rodarima/robotica/doc/coco.pdf

# Coco

Rodrigo Arias Mallo
rodrigo.arias@udc.es

## 1. Descripción

Coco es un robot diseñado para aprender los principios básicos de la robótica. Ha sido creado con la intención de reutilizar componentes de antiguos aparatos y darles un nuevo uso. Así como para comprender los fundamentos teóricos aplicados en un experimento práctico.

### 1.1. Sensores

Cuenta con varios sensores que le permiten obtener información del entorno, así como información sobre sí mismo. A cada sensor se le asigna un nombre corto, terminado en un número, que permite identificarlo. Los sensores son los siguientes:

1. sonar0: Sensor de ultrasonidos HC-SR04
2. mouse0: Ratón de bola
3. ldr0: Sensor de luz LDR ambiental
4. ldr1: Sensor de luz LDR dirigido hacia delante
5. antr: Antena derecha
6. antl: Antena izquierda

### 1.2. Actuadores

El robot dispone de dos motores DC a ambos lados que le permiten moverse por el entorno. También puede emitir señales a través de sus leds. Incluye tres LEDS en la parte frontal, que conjuntamente con el sensor ldr1, le permiten apreciar el color del objeto que tiene delante. A continuación:

1. mtr: Motor derecho
2. mtl: Motor izquierdo
3. ledr: LED frontal rojo.
4. ledg: LED frontal verde.
5. ledb: LED frontal azul.
6. led0: LED de información.

## 2. Calibración de sensores

### 2.1. sonar0: Ultrasonidos HC-SR04

El sensor de ultrasonidos, permite averiguar de forma estimada la posición de un obstáculo. Para ello dispone de un emisor y un receptor de ultrasonidos orientados hacia delante, y posicionados en la parte frontal del robot.

Para calcular la distancia al objeto, se mide el tiempo que tarda un pulso ultrasónico en viajar desde el emisor al objeto, y tras rebotar, volver al receptor.

Ya que el sonido ha de rebotar en el objeto, la superficie del mismo influirá en gran medida en la información captada por el sensor. Las superfies de tela o espuma, absorben casi todo el sonido que emite el sensor, por lo que son indetectables para el robot.

La velocidad del sonido, depende de la temperatura del aire T, además de otros factores¹
. Sin embargo,
para una simplificación de los cálculos, se empleará la siguiente fórmula, asumiendo que la temperatura T en grados Celsius es la misma en todas partes:
vs = 331,3 + 0,606T | (1)

Por lo tanto, si te es el tiempo que tarda el sonido en llegar desde el emisor al obstáculo, y tr el tiempo desde que rebota en el obstáculo hasta el receptor:

s1 = vste s2 = vstr

s1 es la distancia del sensor al objeto, en el momento de lanzar el pulso. s2 es la distancia desde el objeto al robot, que puede estar en movimiento y ser diferente a s1. El sensor mide t que es te + tr.

Si se supone que el robot esta parado cuando se realiza la medición, s1 = s2 y por tanto te = tr. Finalmente, s es la distancia del sensor al obstáculo:

s = s1 = s2 = vs

t
2

(2)

Es importante mencionar que s no indica la posición exacta del obstáculo, si no la distancia del mismo al sensor.

En el caso de que el robot se mueva con una velocidad ~v, si esta velocidad es pequeña comparada con la del sonido, se puede despreciar. Una velocidad de 1m/s, provocaría una diferencia en la distancia estimada de un objeto a 3m, de aproximadamente 9mm.

### 2.1.1. Ángulo de apertura θs

Para calibrar el sensor, es necesario determinar el ángulo de apertura θs, que indica hasta que punto el sensor puede recibir el eco del sonido que rebota en los objetos. De modo que se realizarán una serie de experimentos, que indicarán de forma experimental dicho ángulo. En la figura 1 se observa un esquema del experimento.

Primero un objeto se coloca en el campo de visión del sensor, en C1. Luego se desplaza hacia A2, siguiendo una trayectoria circular centrada en O, y se observa el ángulo θ1 en el que deja de observarse dicho objeto. De igual modo se repite en el otro sentido, y se calcula el ángulo θ2.

Dado que el sonar puede no estar centrado, se anotarán las medidas de θ1 y θ2, para luego estimar θs.

Tras realizar las mediciones, se obtienen los siguientes resultados:

1http://en.wikipedia.org/wiki/Speed_of_sound#

Practical_formula_for_dry_air (http://en.wikipedia.org/wiki/Speed_of_sound#Practical_formula_for_dry_air)

C2

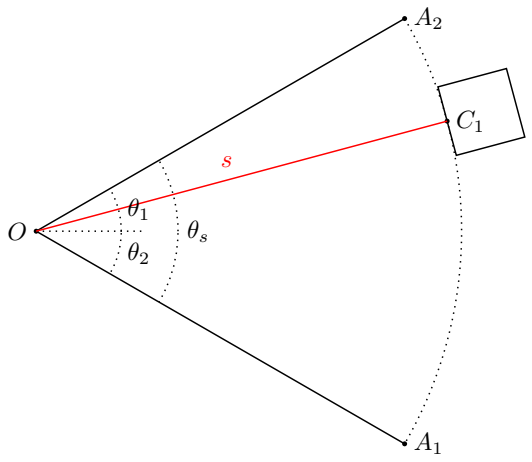
[picture p11: figure]

Figura 1: Experimento para calcular el ángulo θs en el sensor de ultrasonido.

s (m) | θ1( o ) | θ2( o )
±5mm | ±1 o | ±1 o
0,20 | 30 | 27
0,30 | 30 | 27
0,40 | 31 | 28
0,50 | 28 | 26
0,60 | 30 | 28
0,80 | 31 | 29
1,00 | 29 | 29
1,20 | 30 | 28

De forma que se aproxima el valor empleando la media aritmética a:

θ1 = 30 ± 1

o
θ2 = 28 ± 1

o

Finalmente, para θs:

θs = 58 ± 2

o

El fabricante indica un ángulo de apertura de 60o ,
centrado, con 30o hacia cada lado. De forma que el resultado obtenido experimentalmente se acerca bastante al resultado esperado.

### 2.1.2. Distancia medida

Para completar la calibración, es necesario poder calcular la distancia s, sabiendo el tiempo t. Para ello, se realizará otro experimento, midiendo las distancias de forma manual sr con una regla, y comparándolas con el valor teórico st, calculado con la ecuación 2.

Se observa que el valor teórico st, no coincide con el valor real medido sr.

sr(m) | st(m) | t(µs)
±0, 05 | | ±20
0,20 | 0,138 | 805
0,30 | 0,210 | 1225
0,40 | 0,281 | 1638
0,50 | 0,353 | 2060
0,60 | 0,429 | 2500
0,80 | 0,568 | 3305
1,00 | 0,713 | 4155
1,20 | 0,859 | 5000
0,2 | 0,4 | 0,6 | 0,8 | 1 | 1,2

1,000

2,000

3,000

4,000

5,000

6,000

7,000

## Distancia del objeto (m)

## Tiempo de eco (

µs)

Erróneo | Corregido | T eórico

Figura 2: Valores experimentales del sensor de ultrasonidos.

Sería posible solucionar el problema empleando una corrección del error. Para ello se emplea una regresión lineal. Con Octave, polyfit muestra los coeficientes de la recta:

2.3864e+02 7.8846e-03

Cuya recta (azul) se puede observar en la figura 2. Su ecuación es:

s = 238,64t + 7,8846 · 10⁻³

Después de repasar el programa que muestra el tiempo que tarda el pulso de ultrasonidos en regresar, se ha detectado un error, provocado en una función de las bibliotecas de Arduino.

Resulta que la función pulseIn calcula el tiempo que dura un pulso, empleando un bucle, en el que se incrementa un contador. Luego multiplica las vueltas del bucle por el número de instrucciones que de antemano se han calculado. Sin embargo, el compilador avr-gcc puede alterar el número de instrucciones cuando se aplican optimizaciones. Este problema, provoca que el tiempo se vea alterado de la forma treal = t ∗ K. Siendo K = 1,3898, hallado de forma experimental.

Tras programar una nueva biblioteca para emplear el sensor de ultrasonidos, de forma independiente a las optimizaciones del código (empleando interrupciones), se vuelven a realizar las medidas.

sr | st | t
m | m | µs
0.20 | 0.193 | 1122
0.30 | 0.293 | 1705
0.40 | 0.392 | 2285
0.50 | 0.489 | 2848
0.60 | 0.588 | 3422
0.80 | 0.789 | 4597
1.00 | 0.998 | 5810
1.20 | 1.197 | 6970

Obteniendo por regresión lineal, de la misma forma, los coeficientes:

1.7084e+02 1.0857e-02

Y por tanto, la recta característica (negro) es:

s = 170,84t + 1,0857 · 10⁻² = 341,68

t
2

+ 1,0857 · 10⁻²

Existe un error fijo de aproximadamente un centímetro (1.0857cm), que puede deberse a la dificultad de centrar la regla en el centro del sensor de ultrasonidos. Sin embargo, para determinar la distancia de un objeto al robot, esta distancia es despreciable.

Si comparamos la ecuación 1, con el resultado experimental, despreciando el desplazamiento de 1cm, se puede observar que son muy similares.

En la figura 2 la recta teórica en rojo, es muy similar a la recta experimental corregida, en negro.

La velocidad del sonido calculada de forma experimental, resulta ser 341,68 m/s. Este valor puede oscilar, ya que depende de la temperatura. Para calcular la temperatura:

T =

vs − 331,3
0,606

= 17,129◦C

La temperatura registrada de la sala es de 18o
. Por lo
que se puede afirmar que el experimento muestra unos resultados esperados.

El error medio de distancia cometido, en el peor caso (a 1.20m de distancia real) es de unos 4mm.

Es importante mencionar, que un ajuste del error, empleando un método de regresión, permite solventar errores como el que ha sido detectado, pero no los corrige. Por ello, se ha decidido que si los cálculos teóricos, no concuerdan con los esperados, debe averiguarse que ha causado el error.

### 2.2. LDR

El sensor LDR permite obtener una medida de la cantidad de luz que incide sobre el mismo. El robot dispone de dos sensores LDR. Uno ambiental, que está colocado en la parte superior, orientado hacia arriba. Además está cubierto por un cilindro cerrado de 4cm de altura, de plástico blanco translúcido. Esto le permite obtener una medida de la luz ambiente sin importar la dirección de donde proviene.

El sensor LDR direccional, se encuentra en la parte delantera orientado al frente. Este sin embargo, está encapsulado en un cilindro abierto, de plástico negro opaco. Lo cual le permite observar de forma direccional la luz que recibe por el frente, con el objetivo de encontrar una luz.

### 2.2.1. ldr0: LDR ambiental

Para calibrar el sensor ambiental, se realizarán algunas medidas comparando la distancia a un foco de luz. También se compararán los valores con distintos ángulos, para observar si realmente es invariante a la orientación.

El valor medido por el sensor, está representado en un intervalo [0, 1024) de valores discretos. El valor 0, corresponde con un voltaje de 0V en la entrada de Arduino, y 1023 con +5V. De forma que si l0 es el valor discreto medido por Arduino:

V0 = 5 ·

l0
1023

En la figura 3 se observa el montaje del LDR R2, junto con otra resistencia R1 de un valor fijo de 10kΩ.

R1

V0

R2

V

Figura 3: Circuito del sensor LDR.

Para calibrar el sensor ambiental, se realizarán algunas medidas observando el valor de la resistencia del LDR, mientras se varía la distancia del foco de luz, así como el ángulo.

En cada medida, el sensor realiza 5000 mediciones de forma contínua, y luego envía el valor de la media aritmética al ordenador, que es registrado.

s(m) | 0 o | −90o | +90o | +180o
0.20 | 936 | 926 | 933 | 943
0.40 | 823 | 784 | 831 | 843
0.60 | 719 | 675 | 729 | 742
0.80 | 627 | 576 | 628 | 639
1.00 | 555 | 505 | 560 | 531
1.20 | 500 | 445 | 497 | 489
1.40 | 429 | 396 | 446 | 454
1.60 | 396 | 340 | 407 | 440
1.80 | 378 | 296 | 383 | 405

Cuadro 1: Datos de calibración para ldr0.

0,2 0,4 0,6 0,8 | 1 | 1,2 1,4 1,6 1,8

10²,4

10²,5

10²,6

10²,7

10²,8

10²,9

10³

Distancia a la luz (m)

Valor del sensor

0

o | −90o | 90o | 180o

Figura 4: Resultados de calibración para ldr0.

En la tabla 1, s indica la distancia a la fuente de luz. Los ángulos indican la orientación del robot.

En la figura 4, se puede observar en una escala logarítmica para el eje y, el valor del sensor para cada orientación.

Existe una variación bastante marcada en la orientación de −90o
. Esta variación indica que el sensor recibe menos luz de la esperada. Dicha variación está relacionada con la superficie del robot. Dado que hay cables en la superficie, cuando se coloca a −90o
, los
cables se sitúan entre la luz y el sensor, y provocan una disminución de la intensidad.

En las demás orientaciones no se producen grandes cambios. Por lo que se asume que el sensor es realmente independiente de la orientación.

### 2.2.2. ldr1: LDR direccional

El sensor LDR direccional, por el contrario, trata de aumentar la variación de la luz conforme a la orientación. Para calibrar este sensor se realizará un experimento similar, dividido en 4 orientaciones. Se asume que los valores para los ángulos opuestos, dada la simetría, son iguales.

Se muestran en la tabla 2 los resultados obtenidos. Finalmente, en la figura 5, se muestran también en una escala logarítmica para el valor del sensor.

s(m) | o 0 | 30o | 60o | 90o
0.10 | 1015 | 1011 | 1004 | 977
0.20 | 1015 | 998 | 670 | 404
0.30 | 1013 | 915 | 520 | 414
0.40 | 1011 | 838 | 416 | 314
0.50 | 1008 | 684 | 308 | 254
0.60 | 1004 | 534 | 216 | 202
0.70 | 999 | 500 | 214 | 113
0.80 | 996 | 394 | 188 | 95
0.90 | 992 | 355 | 164 | 80
1.00 | 987 | 352 | 136 | 70
1.20 | 977 | 277 | 96 | 60
1.40 | 968 | 173 | 65 | 57

Cuadro 2: Datos de calibración de ldr1.

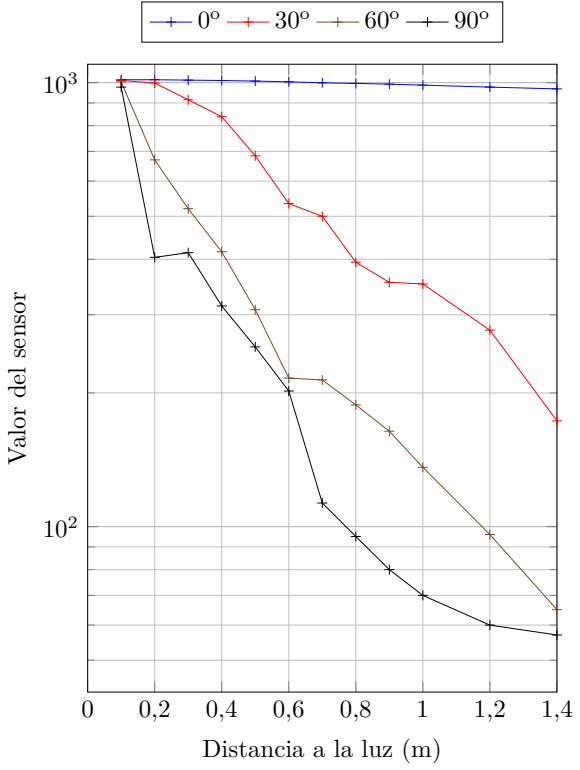
[picture p12: figure]
Distancia a la luz (m); Valor del sensor

Figura 5: Resultados de calibración para ldr1.

### 2.3. mouse0: Ratón de bola

En la parte posterior, un ratón de bola permite obtener mediciones del movimiento del robot. Tiene un controlador EM83702BP, que dispone con dos contadores digitales que realizan la medición del desplazamiento en el eje x e y.

Una bola de goma se encuentra en contacto con el suelo. Al desplazar el ratón, la bola gira alrededor de un eje imaginario, que es perpendicular al sentido del desplazamiento y paralelo al suelo. Desplazándose en la dirección de ~m.

Ya que los movimientos efectuados por el robot serán los que provoquen sus dos ruedas, se puede determinar la posición, midiendo sólo el desplazamiento del ratón. Para ello, se observa en la figura 7 un ejemplo de un giro de α = 45o

### 2.3.1. Movimiento de la bola

Para poder analizar el movimiento que realizará el robot, mediante la información que el ratón proporciona, es necesario conocer como varía el vector ~m que indica el desplazamiento real del ratón, con respecto a la información proporcionada por el mismo.

Para ello, es necesario averiguar el funcionamiento del ratón. Este consta de una bola de goma, que está situada en un zócalo, donde puede girar libremente, al mover el ratón por una superficie.

Dos rodillos de plástico rozan con la bola, desfasados en un ángulo de 90o
. A continuación se analiza, como el movimiento de la bola, roza en los puntos B1 y B2 con los rodillos del ratón. En la figura 15 se observa con detalle el mismo giro que en la figura 7.

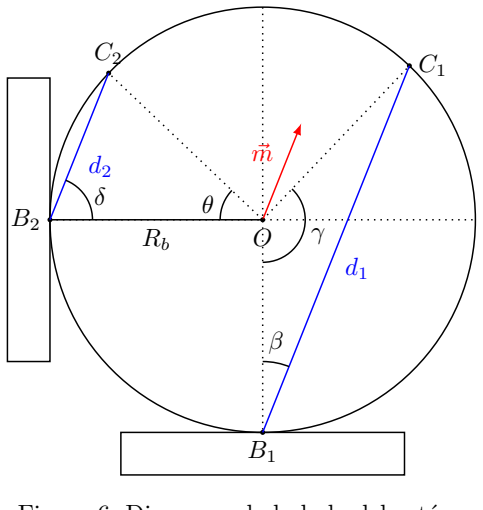
[picture p13: figure]

Figura 6: Diagrama de la bola del ratón.

### 2.3.2. El tamaño de la bola

¿Cómo se mueven los rodillos del ratón, cuando la bola gira? Para responder a esta cuestión, se moverá el ratón un desplazamiento ~m a una velocidad uniforme y en línea recta, y se intentará calcular de forma teórica el resultado esperado.

Los ejes están intercambiados con respecto al orden habitual de un plano. Esto es debido a que el ratón está colocado en el robot como en la figura 15. Sin embargo mantienen el sentido. Hacia arriba y derecha son positivos.

El rodillo inferior, girará rozando continuamente por el punto B1 a medida que la bola gire. Dado que la dirección ~m permanece constante durante este movimiento, el punto B1 describirá una trayectoria circular en la superficie de la bola. La bola tiene un radio Rb.

El perímetro de esta circunferencia se denomina por p1, que es tangente a B1 y C1 y que tiene por diámetro d1. De modo que cuando la bola dé una vuelta completa, el rodillo habrá avanzado exactamente p1.

La distancia d1 es la cuerda de ángulo γ, cuya longitud es, por su propia definición:

d1 = Rb crd γ = 2Rb sin

γ
2

Además, el ángulo γ = 180o−2β, pues forma un triángulo isósceles:

d1 = 2Rb sin(90 − β) = 2Rb cos β

De igual modo para d2:

d2 = Rb crd θ = 2Rb sin

θ
2

Sabiendo que θ = 180o − 2δ y que β = 90 − δ, puesto que d1 k d2:

d2 = 2Rb sin(90 − δ) = 2Rb sin β

Finalmente, para los perímetros:

p1 =

2πd1
2

= 2πRb cos β p2 =

2πd2
2

= 2πRb sin β

Si se supone que no hay ningún deslizamiento entre la bola y el rodillo, cuando la bola avance ~m, ésta girará un ángulo θb:
θb =

m
Rb

Si Rr es el radio de los rodillos, estos girarán un ángulo:

θ1 =

θbd1
2Rr

θ2 =

θbd2
2Rr
Sustituyendo d1 y d2:

θ1 =

θb2Rb cos β
2Rr

=

Rb
Rr

θb cos β

θ2 =

θb2Rb sin β
2Rr

=

Rb
Rr

θb sin β

Recuperando el valor de θb, el radio Rb desaparece:

θ1 =

m cos β
Rr

θ2 =

m sin β
Rr

(3)

De modo que se obtiene una relación entre el ángulo con el que se desplaza el ratón y el giro de cada uno de los rodillos, como se deseaba. Además se observa que el tamaño no importa, de la bola, para calcular el giro de los rodillos.

### 2.3.3. Los optoreceptores

Los rodillos que rozan con la bola, tienen en los extremos unos discos con ranuras equiespaciadas, de modo que cortan un haz de luz infrarrojo al girar. Este efecto, provoca que un sensor registre el número de veces que se ha cortado el haz, y por lo tanto mide, de forma discreta, cuánto ha girado el rodillo, es decir θ1 y θ2.

Cada disco tiene 27 dientes y Rr, el radio de los rodillos, es de 1.4±0.1 mm.

Además, en cada disco se encuentran dos receptores, desfasados 90o
, de forma que pueden detectar el sentido de giro. Por cada diente que se avanza, se cuentan 4 pasos en los contadores digitales.

Si o1 y o2 son los valores medidos por los contadores que acumulan el número de pasos que se ha desplazado el rodillo:

o1 =

27 · 4θ1
2π

o2 =

27 · 4θ2
2π

Sustituyendo el valor del ángulo θ1 y θ2 por la ecuación 3:

o1 =

27 · 4
2πRr

m cos β o2 =

27 · 4
2πRr

m sin β

Añadiendo una constante Kr:

Kr =

27 · 4
2πRr

= 12 ± 2

o1 = Krm cos β o2 = Krm sin β

Esta constante, Kr, ha sido calculada de forma experimental, con un valor de 11,484. Este valor se encuentra dentro del margen calculado, por lo que se considera como válido, y verifica los cálculos realizados.

Kr = 11, 484

Para calcular esta constante, se realizó un movimiento de 150mm, en línea recta y se registraron los valores de o1, que mide el desplazamiento en el eje y:

o1 | 1719 | 1728 | 1722 | 1719 | 1725

Tras calcular la media, y dividirla por 150mm, se obtiene el valor Kr.

Empleando una notación vectorial, ~o es el desplazamiento indicado por el ratón, tras intercambiar sus ejes: ~o = (o2, o1).

De forma que ox = o2 = Krm sin β y oy = o1 = Krm cos β. Ya que mx = m sin β y my = m cos β, se simplifica: ox = Krmx y oy = Krmy, quedando finalmente:

~o = Kr ~m =⇒ ~m =

~o
Kr

(4)

### 2.3.4. El radio de giro Rr

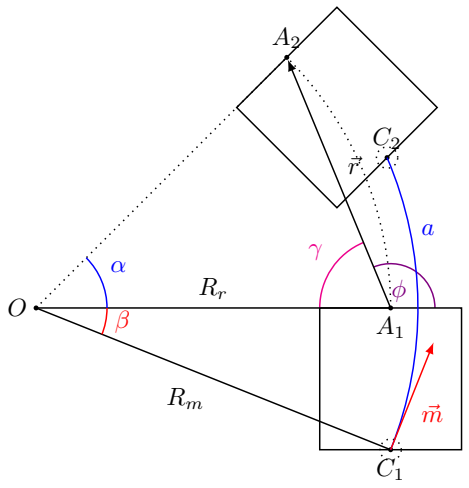
[picture p14: figure]

Figura 7: Diagrama de un giro del robot.

Para calcular el radio de giro Rr del robot se empleará el triángulo OA1C1 que comparte el lado Rr con el triángulo OA2A1.

l es la distancia que separa el ratón del eje de las ruedas, l = A1C1. Rm es el radio desde el O hasta el ratón, C1.

Observando el ángulo β se cumple que:

sin β =

l
Rm

=

mx
m

=⇒ Rm =

l · m
mx

(5)

Ahora, tomando el triángulo OA1C1:

Rr = Rmcosβ = Rm

my
m

=

l · m · my
mx · m

=

l · my
mx

(6)

### 2.3.5. El ángulo α

En un giro el robot mueve el ratón en la trayectoria descrita por el arco a, como muestra la figura 7. Dado que el ratón gira acompañando al robot, la trayectoria percibida por el mismo, es en línea recta, y de una longitud exactamente igual a a. De forma que:

m =

q
m²

x + m²
y = a

Si Rm = OC1, dado que α = A1dOA2 = C1dOC2, se tiene que a = αRm. Junto con lo anterior:

m = αRm

Empleando la ecuación 5:

α =

m
Rm

=

m · mx
l · m

=

mx
l

(7)

### 2.3.6. El vector ~r

Para determinar la posición del robot, es necesario calcular el vector ~r. Este vector indica el deplazamiento del robot, usando un sistema de coordenadas local. Observando el ángulo φ:

rx = r cos φ ry = r sin φ

En forma matricial, empleando Rφ como matriz de rotación:

~r =

rx
ry
= Rφ
r
0
=
cos φ − sin φ
sin φ cos φ

r
0
(8)

Y ya que r es la cuerda de radio Rr y ángulo α, se tiene que:

r = Rr crd α = 2Rr sin

| α
| 2

Junto con las ecuaciones 7 y 6:

r = 2Rr sin

mx
2l

=

2lmy mx | sin mx 2l

Dado que existe una división por mx que valdrá 0 cuando el robot avance en el eje y, es necesario evitar la división por cero:

r =

2lmy
mx

sin

mx
2l

si mx 6= 0

my | si mx = 0

(9)

### 2.3.7. El ángulo global θ

θ indica en un sistema de referencia global S, el ángulo del robot. En cada giro cambia, y ha de actualizarse. Si ∆θ es el giro que se produce en un intervalo ∆t, tras cada actualización:

θ(t + ∆t) = θ + ∆θ

Observando la figura 7, α indica el giro que describe el robot, en ∆t, por lo que ∆θ = α:

θ(t + ∆t) = θ + α | (10)

Siendo α el ángulo que gira el robot entre t y t + ∆t.

### 2.3.8. La posición global ~s

El vector ~s(t) indica la posición del robot en el instante t, tomando un sistema de referencia global S:

~s(t + ∆t) = ~s(t) + ∆~s

Sin embargo, el vector ~r(t), indicará el deplazamiento en el instante t, pero en el sistema de referencia del robot S

0

Para transformar el vector ~r de S

0 a S es necesario
tener en cuenta el ángulo θ que poseía el robot al comenzar el desplazamiento:

∆~s = Rθ~r

Substituyendo ~r por la ecuación 8:

∆~s = RθRφ

r
0
= Rθ+φ
r
0

Realizando la multiplicación de la matriz:

∆sx = r cos(θ + φ) ∆sy = r sin(θ + φ)

De forma que para cada ∆t:

sx(t + ∆t) = sx(t) + r cos(θ + φ) sy(t + ∆t) = sy(t) + r sin(θ + φ)

(11)

### 2.3.9. Odometría

Para determinar la ubicación del robot, bastará con conocer la posición y el ángulo del robot, usando el sistema de referencia global S. De esta forma, la tupla (~s, θ) contiene toda la información necesaria para ubicar al robot.

Cada vez que el sensor mouse0, indique el vector ~o, ha de calcularse ~m. Luego actualizar la posición global ~s y finalmente el ángulo global θ.

### 2.4. Motores

Para efectuar el movimiento, el robot dispone de dos motores Mabuchi RF-500TB-12560, colocados a ambos lados. Estos motores eléctricos de corriente contínua, son rápidos y ligeros, pero no tienen la precisión de los motores paso a paso. Así que para poder controlar la velocidad y aceleración, es necesario realizar una serie de pruebas de calibración.

### 2.4.1. Relación velocidad-voltaje

Aplicando diferentes configuraciones de ondas PWM, es posible variar la velocidad de los motores con arduino. De modo que se ha realizado un experimento en el que el robot ejecuta un movimiento en línea recta durante 2 segundos, manteniendo una alimentación constante en ambos motores. El resultado puede verse en la figura 8.

Se observa que al comienzo, los motores experimentan una aceleración, tras la cual, se estabilizan en una velocidad relativamente constante, y finalmente se detienen tras un período de frenado.

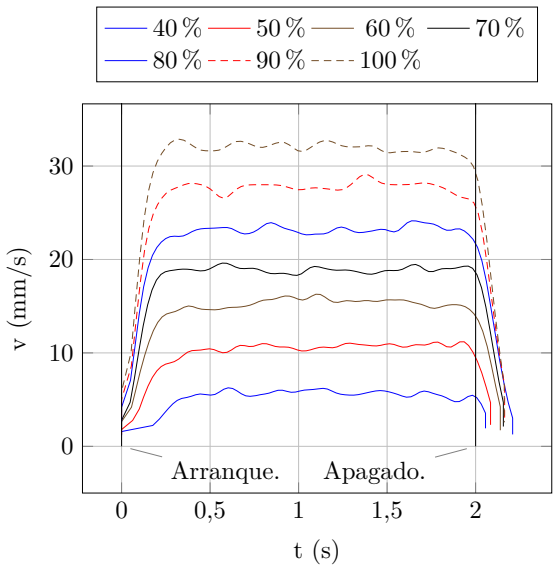
[picture p15: figure]
Arranque.; Apagado.

Figura 8: Arranque y parada de los motores, con diferente ciclo de trabajo, a 5V. Se observa una curva de arranque, y otra de detención, debido a la inercia.

Es importante conocer la velocidad de los motores, para poder tener una mejor información de odometría. En la figura 9 se observa como aumenta la velocidad conforme se aumenta el ciclo de trabajo de la onda PWM.

Las ecuaciones que describen la aceleración del motor permitirían contrastar la forma de la función. Sin embargo, no serán analizadas aquí, debido a la gran complejidad que conforma un motor. Para estimar la gráfica, se realizará una aproximación lineal. La interpolación que se muestra en la figura 9 es la siguiente recta:

f(x) = 41,9103x − 8,4458

## 3. Errores en las bibliotecas de

Arduino.

La función attachInterrupt no borra las banderas (flags) INTF0 y INTF1 del registro EIFR, de forma que al colocar una interrupción por primera vez, es posible que se ejecute al comienzo sin haber recibido tal interrupción. Una posible solución es añadir esta línea al comienzo de la función:

EIFR |= _BV(INTF0) || _BV(INTF1);

La función pulseIn calcula el tiempo transcurrido dependiendo del número de instrucciones que contiene un bucle. Este número puede variar con las optimizaciones que se realicen. Debe ser invariante.

Además es conveniente sustituirla por alguna función no bloqueante que emplee interrupciones.

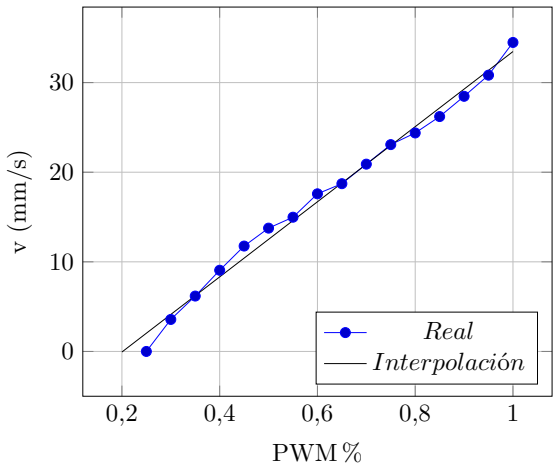
[picture p16: figure]
PWM %; Real Interpolación

Figura 9: Arranque y parada de los motores, con diferente ciclo de trabajo, a 5V. Se observa una curva de arranque, y otra de detención, debido a la inercia.

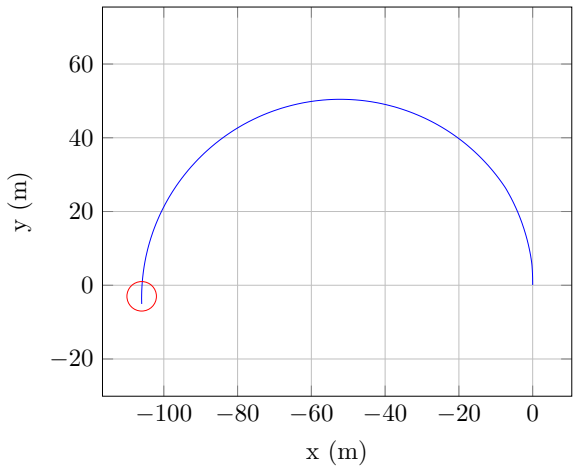
[picture p17: figure]

Figura 10: Giro de 180o
. Se observa que excede el giro en unos 5,5o
, debido a la inercia de los motores.

## 4. Trabajo futuro

Existen algunos temas que no se han podido tratar, por falta de tiempo. Son las ecuaciones que describen el comportamiento de la luz, cuando se varía la distancia a la fuente, o cuando se varía el ángulo del sensor.

Las ecuaciones del arranque del motor, se han ignorado, pero analizarlas podría mejorar los cálculos de odometría.

La última versión de este documento se encuentra en https://github.com/rodarima/robotica.

## 5. Detalles de los sensores

A continuación se muestran algunas fotos que muestran los sensores con detalle.

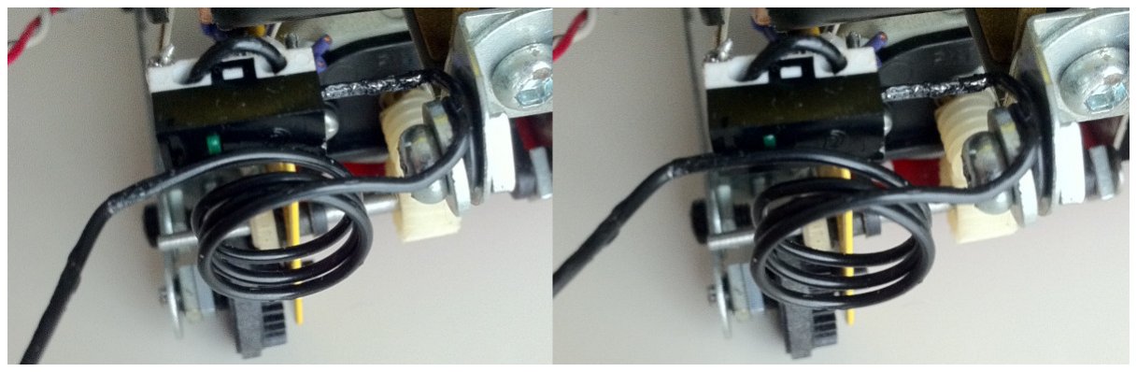
[picture p18: figure]

Figura 11: Detalle del mecanismo de las antenas: En la izquierda desactivada; en la derecha activada.


Figura 12: Sensor de luz ambiental ldr0.


Figura 13: Construcción del sensor ldr0.


Figura 14: Sensor direccional ldr1, junto a los leds RGB para identificar el color.


Figura 15: Se observa el interior del ratón de bola. Dos rodillos perpendiculares en contacto con la bola, con discos dentados en los extremos. Una marca blanca permite observar una desviación del robot.


Figura 16: Sensor de ultrasonidos snr0. El emisor se encuentra a la derecha (T) y el receptor a la izquierda (R).

## 6. Detalles del robot

Por último una visión general del robot.


Figura 17: Se observa el mecanismo de engranajes que transmiten la rotación del motor a las ruedas.


Figura 18: Batería de 1,2 · 8 = 9,6V. Gracias al grupo GII por las piezas.


Figura 19: Vista superior del robot.


Figura 20: Vista superior del robot desmontado.
