rodarima/robotica/doc/img/ant-closed.jpg

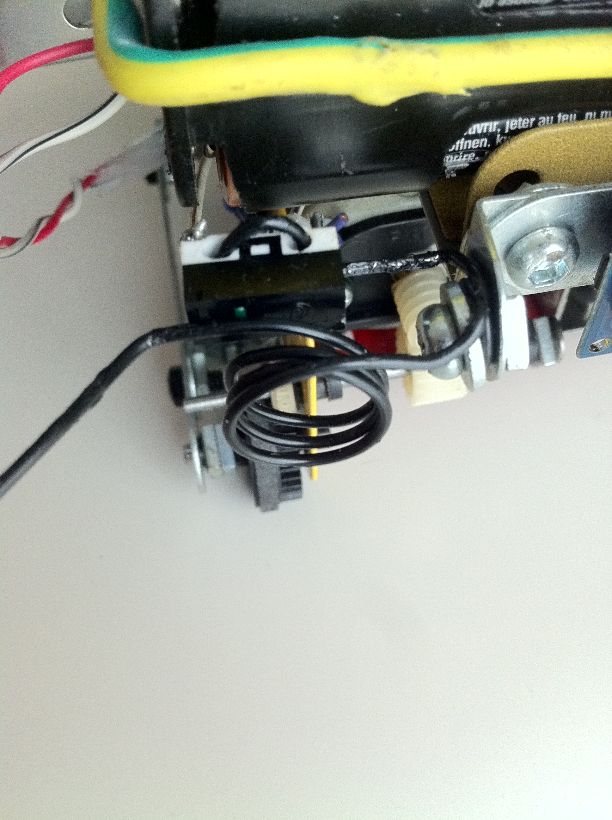
doc/img/ant-closed.jpg
