rodarima/robotica/doc/img/ant-open.jpg

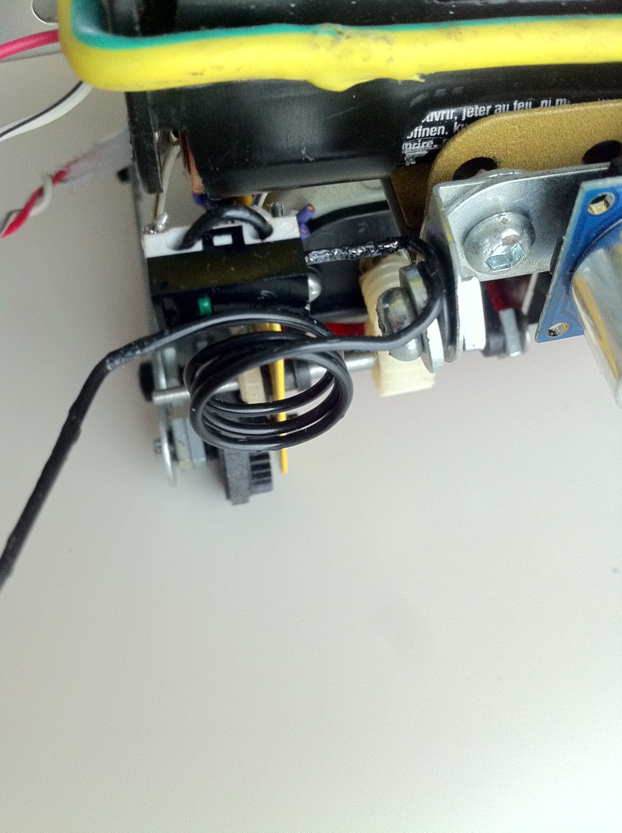
doc/img/ant-open.jpg
