rodarima/robotica/doc/img/coco-piezas.JPG

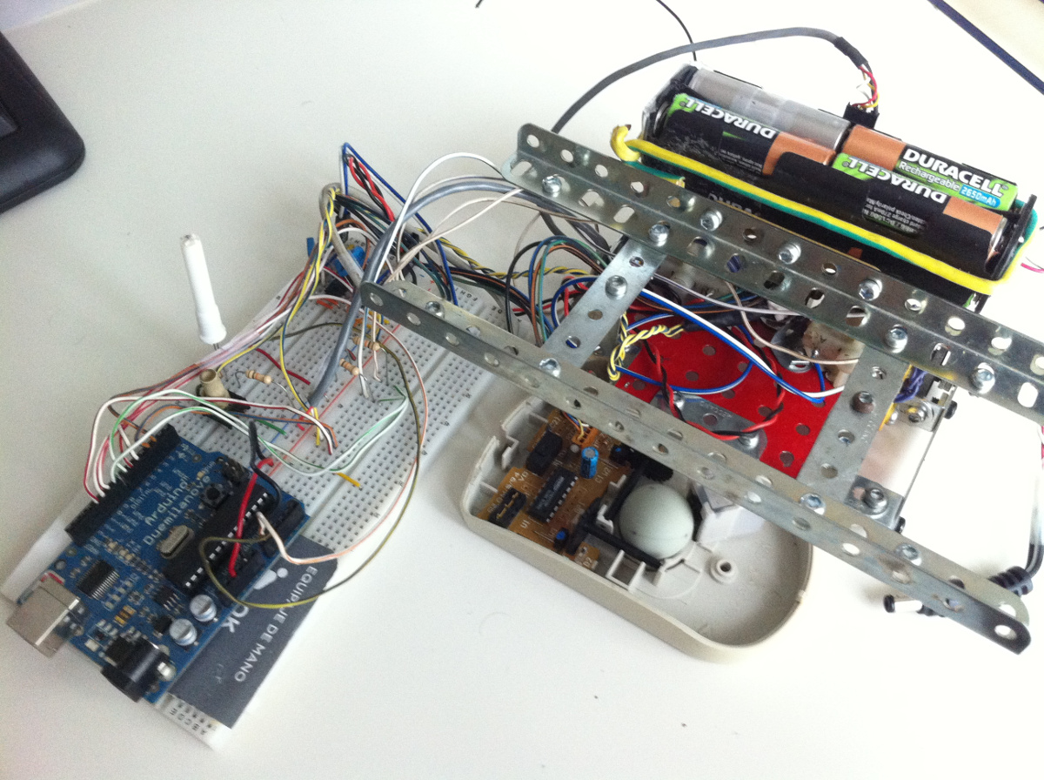
doc/img/coco-piezas.JPG
