rodarima/robotica/doc/giro1.dxf

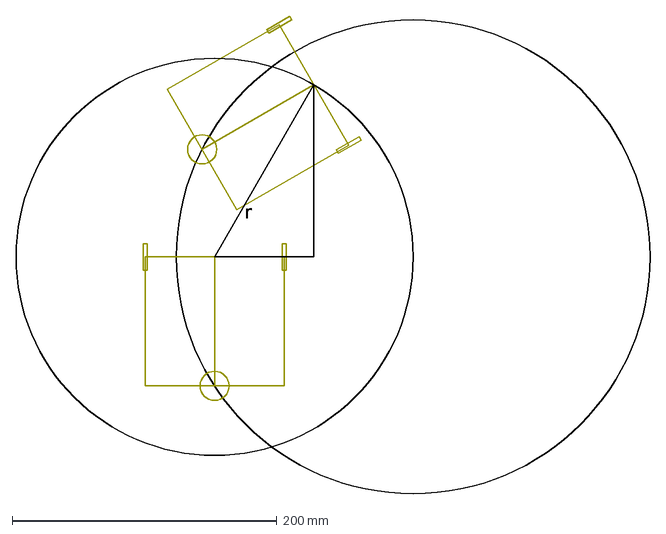
[picture p22: CAD file, 2015-03-03, last stored version]
doc/giro1.dxf
r
