rodarima/robotica/arduino/pinout.h

#ifndef _PINOUT_H_
#define _PINOUT_H_

/* Pines de los motores */
#define PIN_MTR0	9
#define PIN_MTR1	10
#define PIN_MTL0	5
#define PIN_MTL1	6

/* Pines del sensor de ultrasonidos */
#define PIN_SNR0S	11
#define PIN_SNR0R	3

/* Interrupción del eco */
#define INT_SNR0	1

#define PIN_LDR0	0
#define PIN_LDR1	1

/* Antenas */
#define PIN_ANTL	7
#define PIN_ANTR	8


#endif
