rodarima/robotica/test/timer2.h

/* Initialize timer2, but don't start the timer2
 * Return:
 * -1: If 'us' is too big.
 *  0: Sucess.
*/
char timer2_init(unsigned long us, (void)*f());

void timer2_start();
void timer2_stop();

void timer2_pause();
void timer2_continue();
