rodarima/robotica/(commit log)

2015-02-02 Añadir doc, osciloscopio y varios sensores.
2015-02-06 Añadir controladores y timer2.
2015-02-09 Añadir controlador para el mouse. BUGGY.
    [mouse-motors.cpp, mouse4.cpp, mouse5.cpp, mouse6.cpp, robot1.cpp, test-timer2.cpp, timer2.c, timer2.h]
2015-02-10 Reparar BUG en timer2. Añadir pruebas de flancos.
    [robot1.cpp, robot2.cpp, serialmouse.cpp, test-serial.cpp, test1-timer2.cpp]
2015-02-11 Añadir biblioteca de ratón.
2015-02-12 Añadir programa de medición de sensores.
2015-02-12 Corregir BUG en attachInterrupt.
2015-03-02 Añadir gráficas de sonar
2015-03-02 Añadir documentación de pines
2015-03-02 Añadir corrección de errores en el ratón
    [serialmouse.cpp]
2015-03-02 Añadir cálculos de odometría.
2015-03-03 Añadir documento con información del robot
    [giro1.dxf]
2015-03-16 Añadir partes de calibración
2015-03-17 Añadir regresión lineal del sensor de ultrasonidos
2015-03-17 Añadir resultados del sensor de ultrasonidos
2015-03-18 Añadir información de LDR y ratón
2015-03-19 Añadir más calculos de la bola
2015-03-19 Añadir ecuaciones de la bola
2015-03-22 Añadir más datos de LDR
2015-03-23 Añadir cálculos de la bola y los optoreceptores
    [ldr0.csv, ldr1.csv]
2015-03-23 Añadir biblioteca de odometría
2015-03-25 Añadir posiciones globales en odometría
2015-03-26 Nuevas ecuaciones para odometría
2015-03-27 Añadir giro de 180º
    [180-cerrado.csv]
2015-03-28 Añadir calibración de velocidad
    [sonar.csv, velocidad-voltaje-10-s.csv, velocidad-voltaje-10.csv, velocidad-voltaje-3-s.csv, velocidad-voltaje-3.csv, velocidad-voltaje-4-s.csv, velocidad-voltaje-4.csv, velocidad-voltaje-5-s.csv]
2015-03-28 Añadir programa de prueba de velocidad-voltaje
2015-03-28 Limpiar doc
    [giro1.dxf]
2015-03-28 Reordenar doc y carpeta de csv
    [180-cerrado.csv, ldr0.csv, ldr1.csv, sonar.csv, velocidad-voltaje-10-s.csv, velocidad-voltaje-10.csv, velocidad-voltaje-3-s.csv, velocidad-voltaje-3.csv]
2015-03-30 Añadir carpeta de bibliotecas locales, y programa de seguir luz
2015-04-20 Comportamientos de seguir pared, esquivar esquinas y seguir luz
2015-04-29 Ajustar valores de umbral para LDR*
2015-04-29 Añadir fotos de los sensores
